angelinaaw/Low-Mismatch-4-Channels-Instrumentation-Amplifier-for-EEG-Signals/Top Level/README.md

# Top Level Integration

**Last Updated:** 26th January

---

## 1. Overview
The top-level integration connects the EEG front-end signal path through three stages of chopper switches (CsA, CsB, and CsB_) feeding into an instrumentation amplifier (INA), followed by another three-stage chopper switch set (CsC, CsB, CsA) and finally a switched-capacitor low-pass filter (LPF). Complementary clocks drive all chopper switches to ensure proper modulation and demodulation, suppressing low-frequency offsets and 1/f noise, while the INA amplifies the differential signal with high input impedance and low noise. The fully integrated digital clocks and precise timing enable a compact, low-power CMOS implementation that delivers a clean baseband EEG output ready for further processing.

**NOTE:** You can run full integration analog circuit netlist (CS-INA-CS-LPF, complementary clk) + digital circuit netlist (Frequency divider) by accessing the .spice from the **Top Integration .spice Folder**. Both result, using PULSE as alternative from digital and using PWL from csv provided from the digital (OpenLane) netlist give the same gain result & waveforms.

For the layout implementation, two GDS versions are provided:
- A full analog layout, generated using the gLayout framework in a Jupyter Notebook environment, and
- A fully integrated layout, combining the analog front-end with the digital block designed in OpenLane, merged and finalized using KLayout.

---

## 2. Schematic Design

### Schematic Design of 3 Chopper Switches Integration

<p align="center">
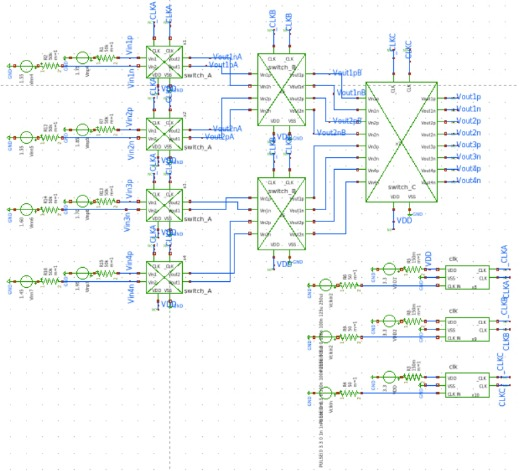
[picture p18: Images/IntegratedCS.jpg]
IntegratedCS
  
</p>
<h4 align="center" style="font-size:16px;">Figure 1. Integrated Schematic of 3 Switches</h4>

### Schematic Design of Top Integrated Circuit
<p align="center">
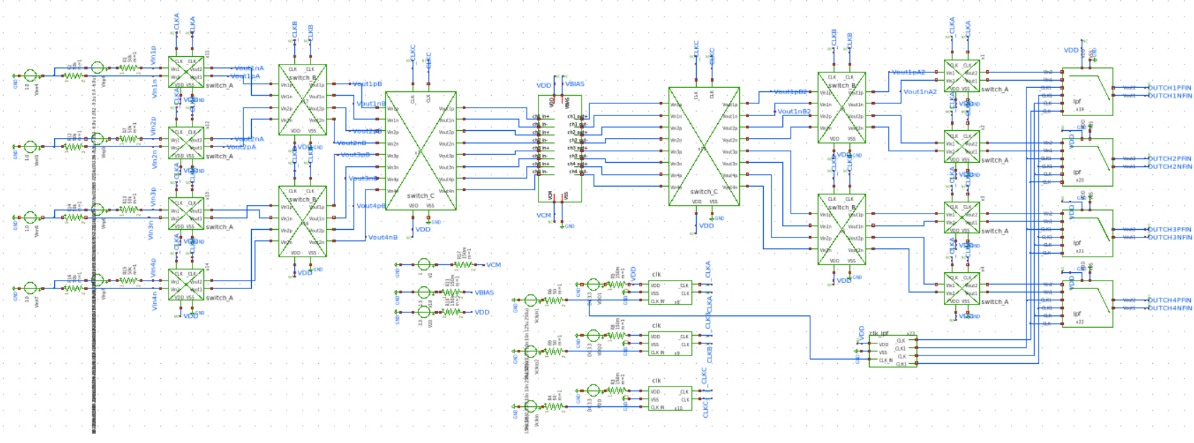
[picture p19: Images/FullSchem.jpg]
  
</p>
<h4 align="center" style="font-size:16px;">Figure 2. Integrated Schematic of the System</h4>

### Schematic Design of External Capacitor (Off-Chip)
<p align="center">
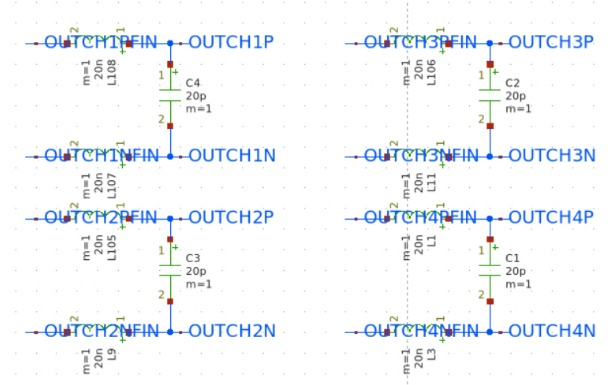
[picture p20: Images/Ext_Cap1.jpg]
  
</p>
<h4 align="center" style="font-size:16px;">Figure 3. External Capacitor Circuit for Outputs (off-chip)</h4>

---

## 3. Simulation Results

### A. Simulations of Top Integration Level Chopper Switches

<p align="center">
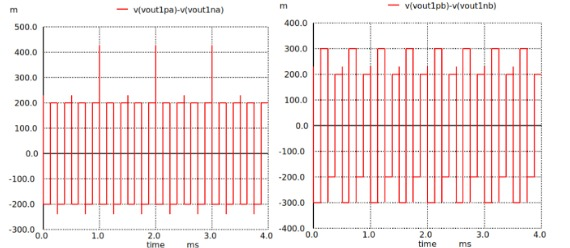
[picture p21: Images/IntegratedCS_Tb1.jpg]
  
</p>
<h4 align="center" style="font-size:16px;">Figure 4. Chopper Switches Integrated TB (1)</h4>
<p align="center">
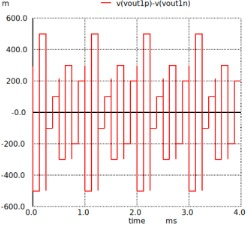
[picture p22: Images/IntegratedCS_Tb2.jpg]
  
</p>
<h4 align="center" style="font-size:16px;">Figure 5. Chopper Switches Integrated TB (1)</h4>

### B. Simulations of Top Integration Level Full Circuit
<p align="center">
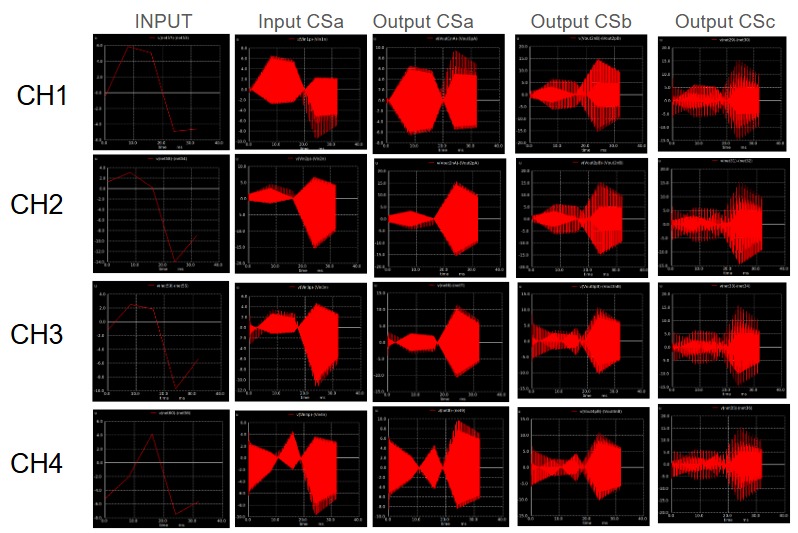
[picture p23: Images/FullSchem_Tb1.jpg]
  
</p>
<h4 align="center" style="font-size:16px;">Figure 6. Output Signals per-Stage in Top Integration (1)</h4>
<p align="center">
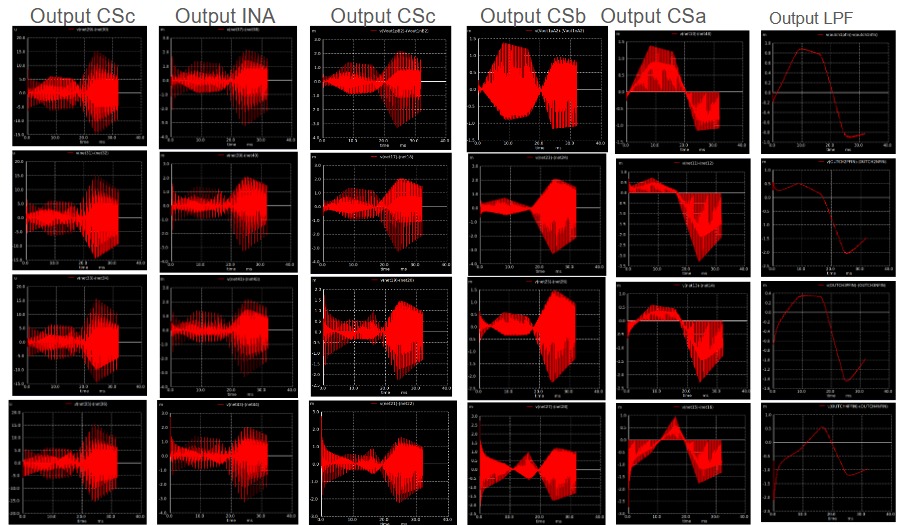
[picture p24: Images/FullSchem_Tb2.jpg]
  
</p>
<h4 align="center" style="font-size:16px;">Figure 7. Output Signals per-Stage in Top Integration (2)</h4>
<p align="center">
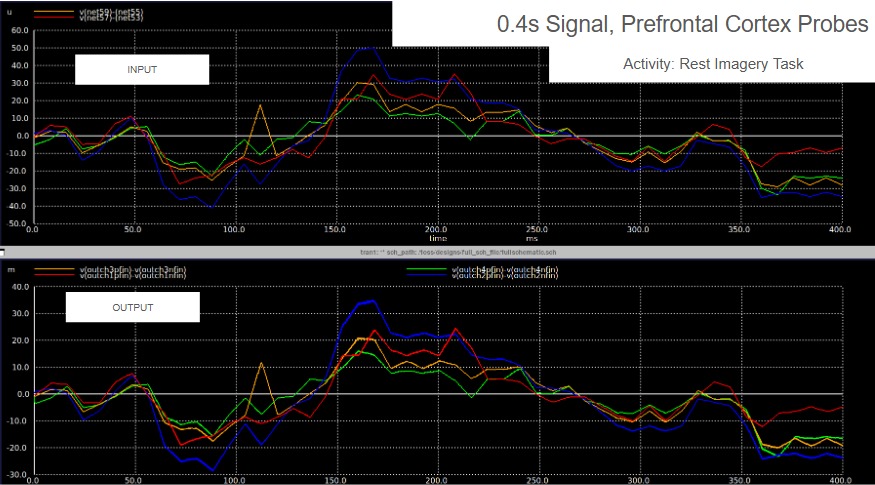
[picture p25: Images/FullSchem_Tb3.jpg]
  
</p>
<h4 align="center" style="font-size:16px;">Figure 8. Simulation Prefrontal Cortex Probes (Input and Output)</h4>

### C. Prefrontal Cortex Signal Analysis

<p align="center">
  LPF_EXT_REV
</p>
<h4 align="center" style="font-size:16px;">Figure 6. Output Signals per-Stage in Top Integration (1)</h4>
<p align="center">
  LPF_EXT_REV
</p>
<h4 align="center" style="font-size:16px;">Figure 7. Output Signals per-Stage in Top Integration (2)</h4>
<p align="center">
  LPF_EXT_REV
</p>
<h4 align="center" style="font-size:16px;">Figure 8. Simulation Prefrontal Cortex Probes (Input and Output)</h4>
