angelinaaw/Low-Mismatch-4-Channels-Instrumentation-Amplifier-for-EEG-Signals/Images/FD_Ly.jpg

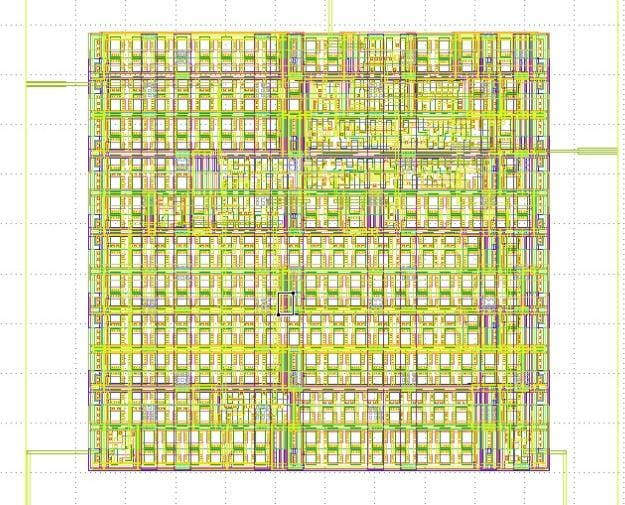
Images/FD_Ly.jpg
