angelinaaw/Low-Mismatch-4-Channels-Instrumentation-Amplifier-for-EEG-Signals/Images/FreqDivLayout.jpg

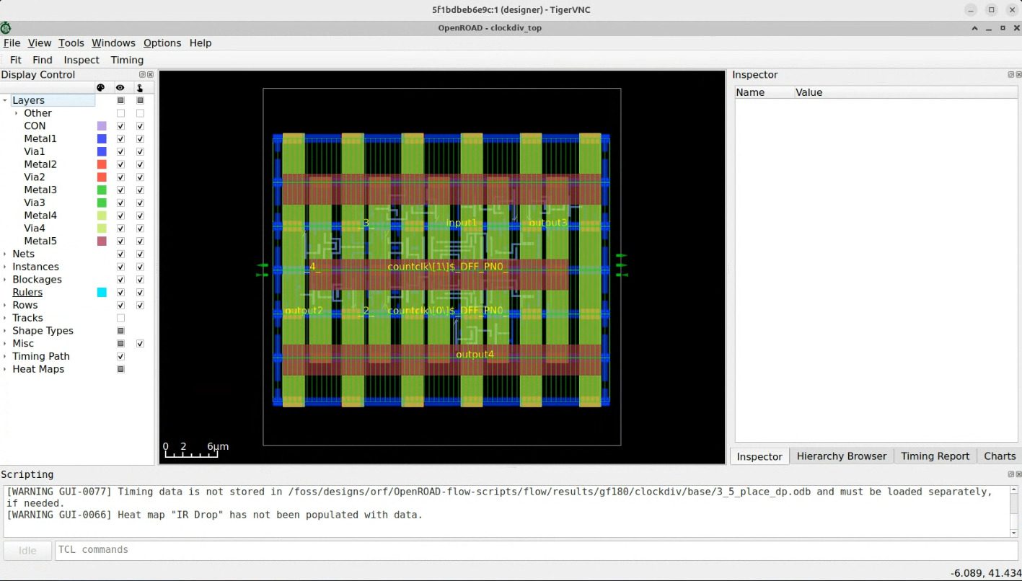
Images/FreqDivLayout.jpg
