angelinaaw/Low-Mismatch-4-Channels-Instrumentation-Amplifier-for-EEG-Signals/Images/FreqDivTb.jpg

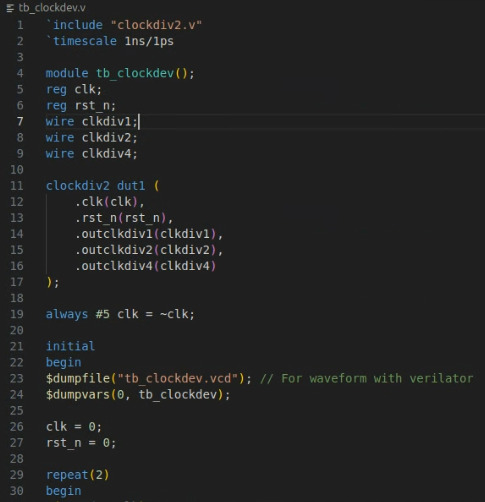
Images/FreqDivTb.jpg
