angelinaaw/Low-Mismatch-4-Channels-Instrumentation-Amplifier-for-EEG-Signals/Images/INAFull.jpg

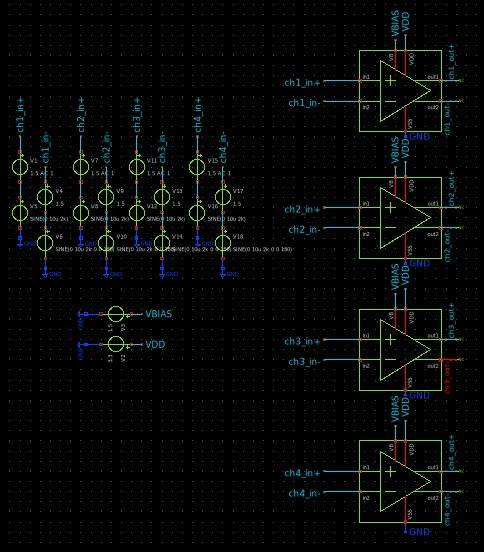
Images/INAFull.jpg
