angelinaaw/Low-Mismatch-4-Channels-Instrumentation-Amplifier-for-EEG-Signals/Images/INASchem.jpg

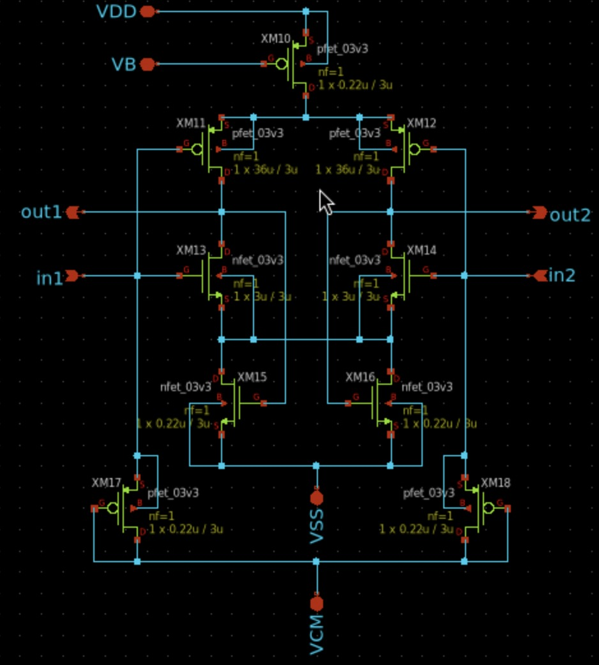
Images/INASchem.jpg
