angelinaaw/Low-Mismatch-4-Channels-Instrumentation-Amplifier-for-EEG-Signals/Images/Plankton.jpeg

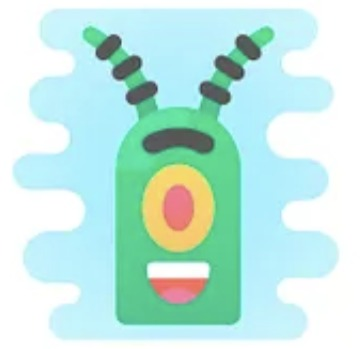
Images/Plankton.jpeg
