angelinaaw/Low-Mismatch-4-Channels-Instrumentation-Amplifier-for-EEG-Signals/Images/ZBEO.jpg

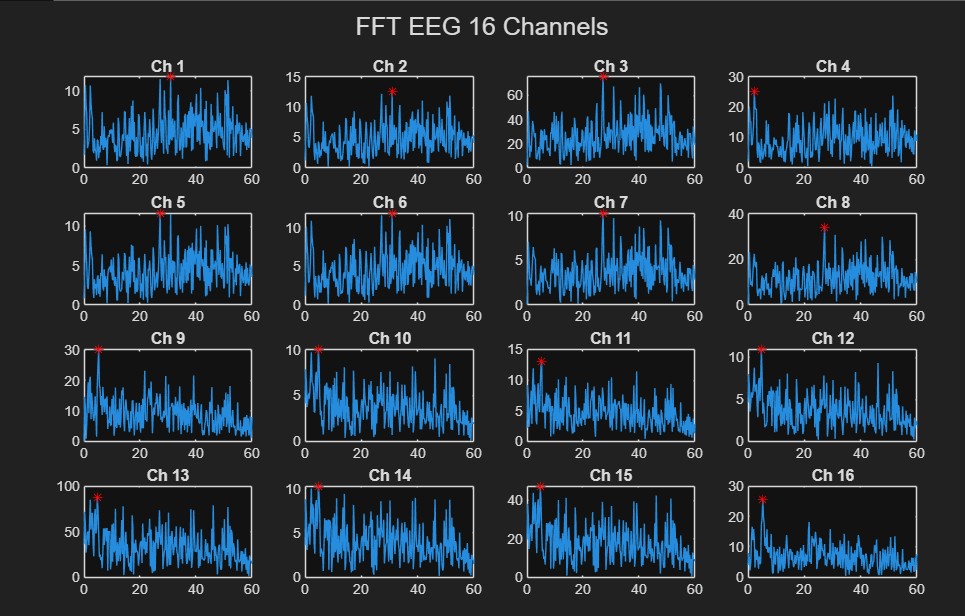
Images/ZBEO.jpg
