angelinaaw/Low-Mismatch-4-Channels-Instrumentation-Amplifier-for-EEG-Signals/Images/ZCLH.jpg

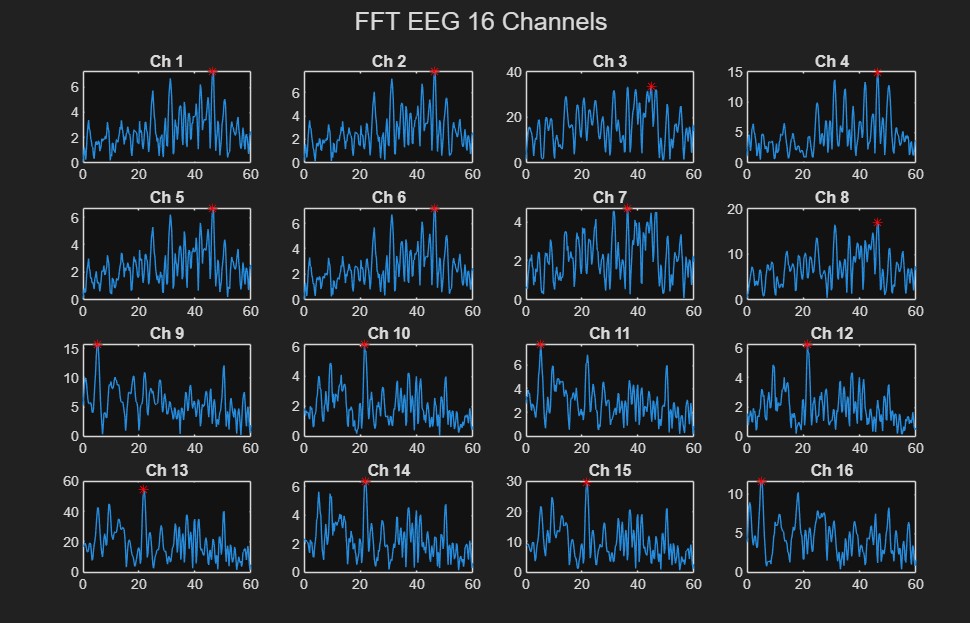
Images/ZCLH.jpg
