angelinaaw/Low-Mismatch-4-Channels-Instrumentation-Amplifier-for-EEG-Signals/Images/ZCRH.jpg

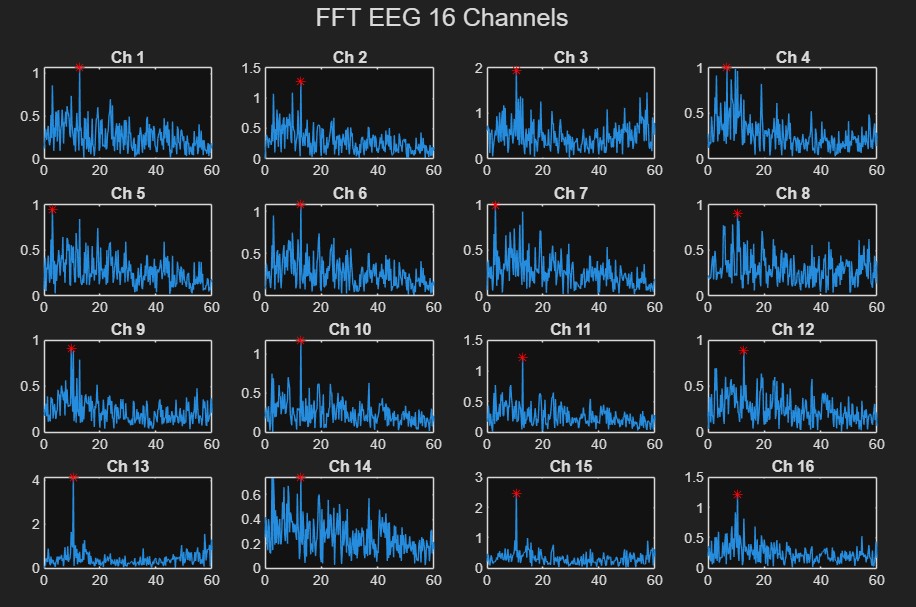
Images/ZCRH.jpg
