angelinaaw/Low-Mismatch-4-Channels-Instrumentation-Amplifier-for-EEG-Signals/Images/ZDLF.jpg

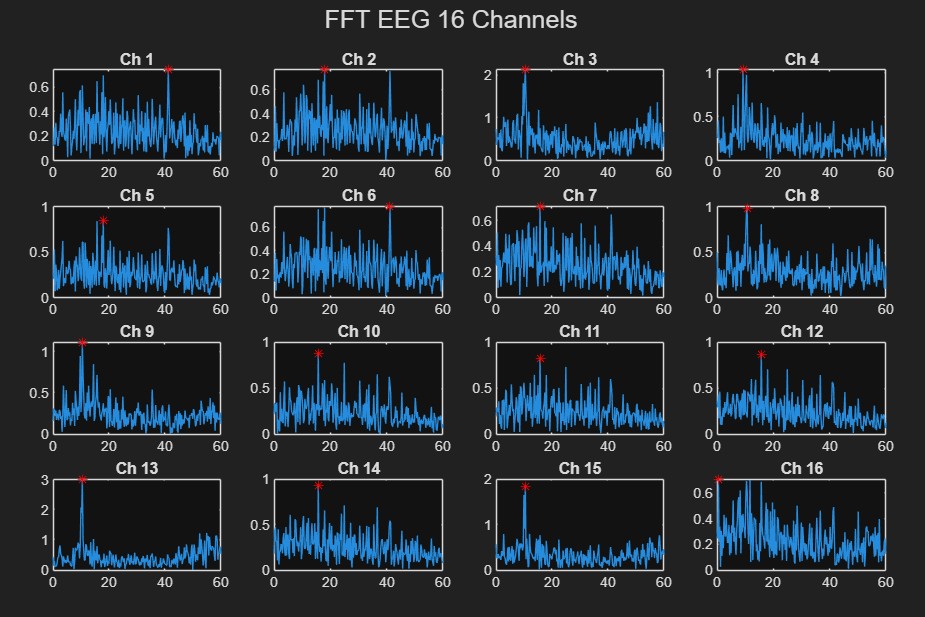
Images/ZDLF.jpg
