angelinaaw/Low-Mismatch-4-Channels-Instrumentation-Amplifier-for-EEG-Signals/Images/ZDRF.jpg

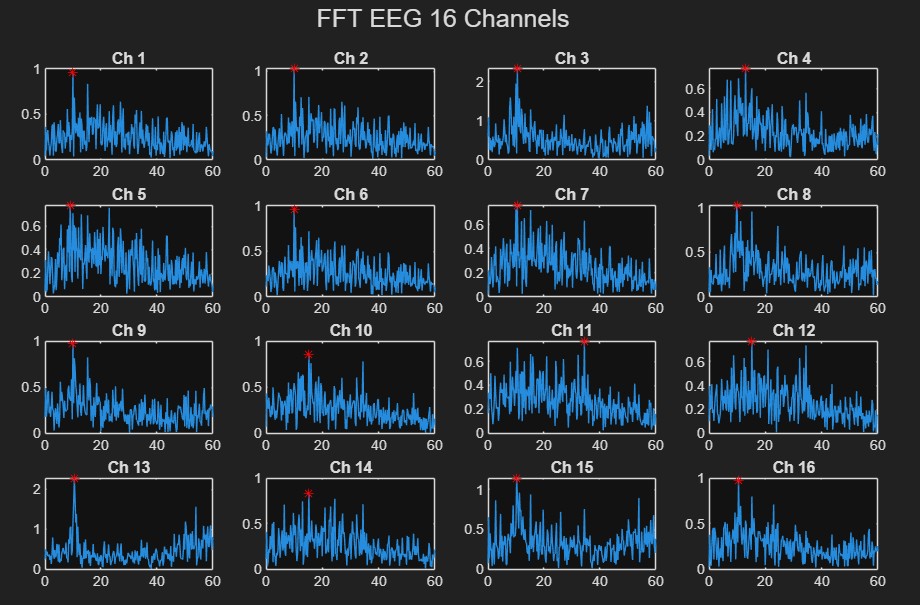
Images/ZDRF.jpg
