angelinaaw/Low-Mismatch-4-Channels-Instrumentation-Amplifier-for-EEG-Signals/Images/ZPLF.jpg

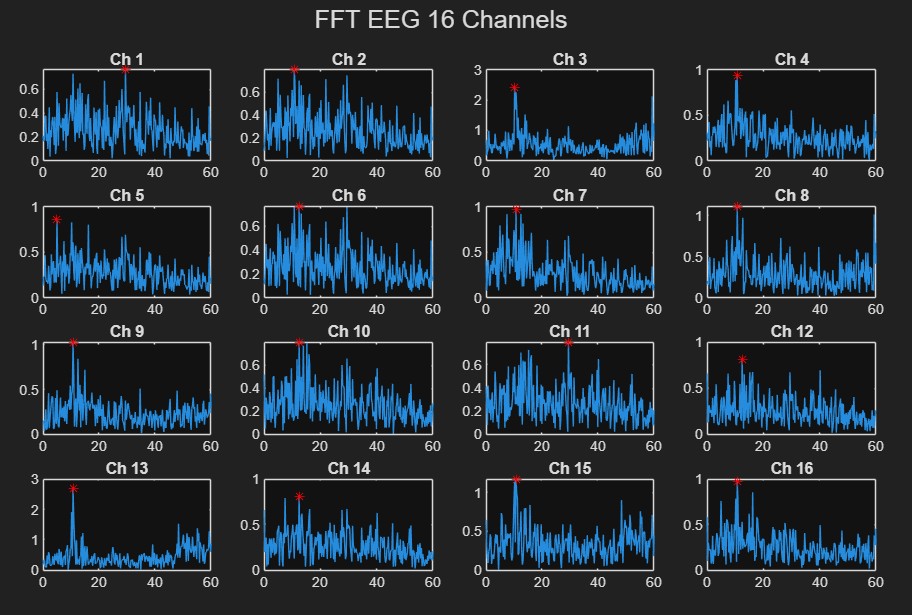
Images/ZPLF.jpg
