angelinaaw/Low-Mismatch-4-Channels-Instrumentation-Amplifier-for-EEG-Signals/Images/ZPRF.jpg

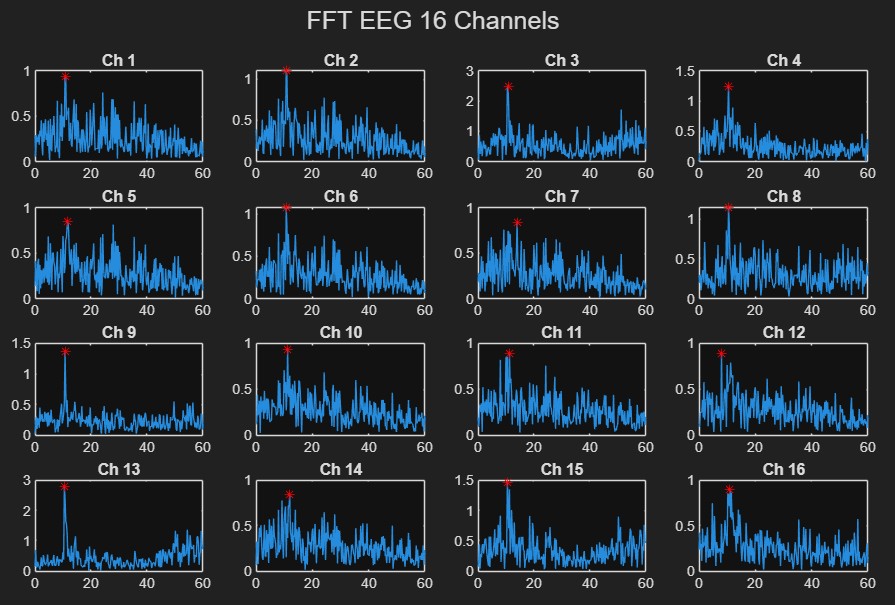
Images/ZPRF.jpg
