angelinaaw/Low-Mismatch-4-Channels-Instrumentation-Amplifier-for-EEG-Signals/(commit log)

2026-01-25 Upload Full SCH File
    Full Schematic for the System (TOP level schematic + block modules)
    [EXT_OPTIONAL_CAP.sch, FULL_INA_FIXED_TB.sch, FULL_INA_TB.sch, Fullschematic.sch, INA_STAGE_FIXED.sch, IntegratedSwitch.sch, LPF_Revised_TB_Only.sch, Switch_B_tb.sch]
2026-01-25 Feat LPF Schematic
    Updated LPF Schematic
    [lpf.sch]
2026-01-25 Feat LPF Schematic
    Fix the Testbench and stuff
    [LPF_Revised_TB_Only.sch, lpf.sch]
2026-01-25 Fix LPF TB
    [LPF_Revised_TB_Only.sch]
2026-01-25 Feat Fix LPF clk sch and sym
    Fix LPF sch and sym
    [clk_lpf.sch]
2026-01-26 Updated the Folder System
    [EXT_OPTIONAL_CAP.sch, FULL_INA_FIXED_TB.sch, FULL_INA_TB.sch, Fullschematic.sch, INA_STAGE_FIXED.sch, IntegratedSwitch.sch, LPF_Revised_TB_Only.sch, Switch_B_tb.sch]
2026-01-26 Added All Schematic Files
    [EXT_OPTIONAL_CAP.sch, FULL_INA_FIXED_TB.sch, FULL_INA_TB.sch, Fullschematic.sch, INA_STAGE_FIXED.sch, IntegratedSwitch.sch, LPF_Revised_TB_Only.sch, Switch_B_tb.sch]
2026-01-26 Rename FIle
    [EXT_OPTIONAL_CAP.sch, FULL_INA_FIXED_TB.sch, FULL_INA_TB.sch, Fullschematic.sch, INA_STAGE_FIXED.sch, IntegratedSwitch.sch, LPF_Revised_TB_Only.sch, Switch_B_tb.sch]
2026-01-26 Update badge link for Chopper Switch progress log
2026-01-26 Moved Top Integration Folder
    [EXT_OPTIONAL_CAP.sch, Fullschematic.sch]
2026-01-26 Renamed Top Integration to Top Level
    [EXT_OPTIONAL_CAP.sch, Fullschematic.sch]
2026-01-26 Revise schematic design section and update figures
